emmanuelhugnot/300CC-V2/README.md

<table width="100%" border="0" cellspacing="0" cellpadding="0">
  <tr>
    <td width="50%" align="center">
      P1520646
    </td>
    <td width="50%" align="center">
      P1520563
    </td>
  </tr>
</table>

# 300CC V2 – Open-Source Paste Extruder (LDM)

The **300CC V2** is an open-source extruder designed by *Emmanuel Hugnot* to make paste 3D printing practical, reliable, and accessible. Built as the evolution of the original *300CC* project, it allows anyone to experiment with materials like **clay, earth, or bio-composites** without needing expensive hardware.

By focusing on a stripped-down design where *every single component serves a clear purpose*, the entire extruder can be assembled for **under €100**.

---

## Key Features

* **Budget-Friendly:** Full assembly costs *less than €100*.
* **Minimalist Design:** Optimized geometry for straightforward assembly, easy maintenance, and reliable extrusion.
* **Versatile Materials:** Ideal for *clays, ceramic bodies, bio-materials*, and other ductile/viscous pastes.
* **FDM to LDM Conversion:** Designed specifically to help users convert standard desktop FDM 3D printers into **Liquid Deposition Modeling (LDM)** machines.

---

## Project Origins & Acknowledgments

The **V2 design** was refined in *September 2026* during a collaborative workshop with **3rd-year design students at ESAD Orléans**. This hands-on collaboration helped test, iterate, and streamline the assembly process to ensure it remains user-friendly and functional.

---

## Getting Started

1. **Check the BOM:** for the complete list of required hardware, fasteners, and electronics.
2. **Print the Parts:** Download the `.STL` files from `3D_FILES/` and slice them using recommended settings in the documentation.
3. **Assemble & Mount:** Follow the step-by-step guide in `300CCV2_Assembly_Guide.pdf` to build the 300CC V2.

---

## Community & Support

This project is built around *sharing knowledge, troubleshooting, and improving paste printing together*.

* **Discussions:** Have questions, ideas, or prints to show off? Head over to the **GitHub Discussions** tab!
* **Contributions:** Feel free to open an issue or submit a pull request if you have improvements or modifications to share.

---
## Author & Contact

Designed and developed by **Emmanuel Hugnot**. 

*  **Website:** [emmanuelhugnot.com](https://emmanuelhugnot.com)
*  **Instagram:** [@emmanuelhugnot](https://www.instagram.com/emmanuelhugnot/)

## License

This project is published under the **Creative Commons Attribution-NonCommercial (CC BY-NC)** license.

*You are free to share, adapt, and build upon this material for non-commercial purposes, provided appropriate credit is given to Emmanuel Hugnot and the 300CC V2 project.*
