emmanuelhugnot/300CC-V2/BOM_300CC_V2.csv

300CC_Extruder V2 | CC BY NC Emmanuel HUGNOT | emmanuelhugnot.com
Quantity | Pieces | Description | Link | Prices
1 | T8 - 250mm + brass nut x2 | T8 Lead screw + brass nut | https://www.amazon.fr/filet%C3%A9es-laiton-filetage-imprimante-machine/dp/B0C5M694W3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 | 6
1 | 6mm GT2 Belt - Perim. 200mm | Transmission Belt | https://www.amazon.fr/QUARKZMAN-200mm-Courroie-Crant%C3%A9e-Largeur/dp/B0H1JWG13S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 | 9,99
1 | Thrust ball bearing | 21x12x5 | https://www.amazon.fr/Kozelo-Roulement-Billes-Pouss%C3%A9e-F12-21M/dp/B0D99DKXSC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 | 9,49
1 | Syringe 300ml | Cartridge | https://www.amazon.fr/cylindre-plastique-laboratoires-scientifiques-industrie/dp/B09CMKM2GF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 | 12,99
1 | Nema 17 + gearbox | Main motor | https://www.amazon.fr/Giilayky-D%C3%A9Rivations-Nema17-Moteur-ExtrudeuseMoteur/dp/B0CP9FNC16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 | 26
1 | 1kg PETG |  | https://www.amazon.fr/DEEPLEE-Filament-30-600mm-Pr%C3%A9cision-Imprimantes/dp/B0DS5TSR6F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 | 19
1 | M3-10mm Pack | Pack of 50 | https://www.amazon.fr/Kozelo-50Pcs-T%C3%AAte-Cylindrique-Creux/dp/B0DDJBKP17?adgrpid=56499440312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 | 8,59
1 | M4 - 35mm | Pack of 10 | https://www.amazon.fr/PRORAJE-M4x35-Filetage-Total-Hexagonale/dp/B0GFH1SPFR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 | 6
 |  |  | Total : | 98,06
