emmanuelhugnot/300CC-V2/3D_FILES/Mainboard.stl

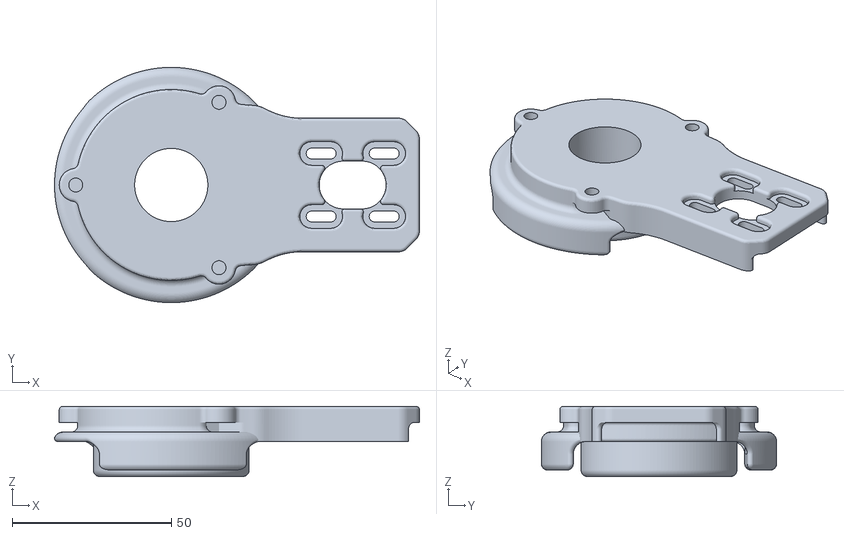
[picture p1: CAD file, 2026-10-01]
3D_FILES/Mainboard.stl
114.7 x 73.9 x 22.0
