emmanuelhugnot/300CC-V2/3D_FILES/Top_mainboard.stl

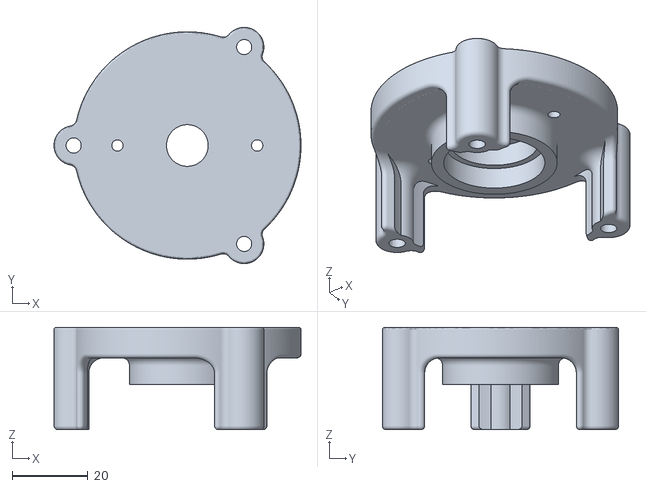
[picture p2: CAD file, 2026-10-01]
3D_FILES/Top_mainboard.stl
65.2 x 62.4 x 27.0
