emmanuelhugnot/300CC-V2/3D_FILES/mount_300CC.stl

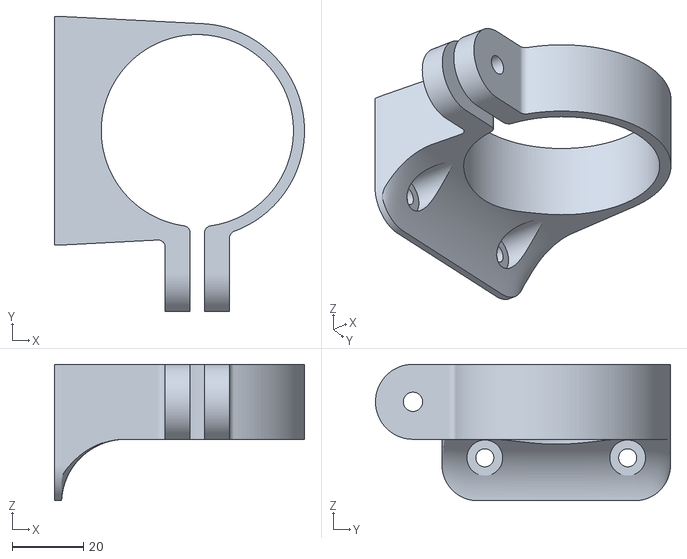
[picture p3: CAD file, 2026-10-01]
3D_FILES/mount_300CC.stl
70.0 x 82.6 x 38.2
