emmanuelhugnot/300CC-V2/3D_FILES/Support_tube.stl

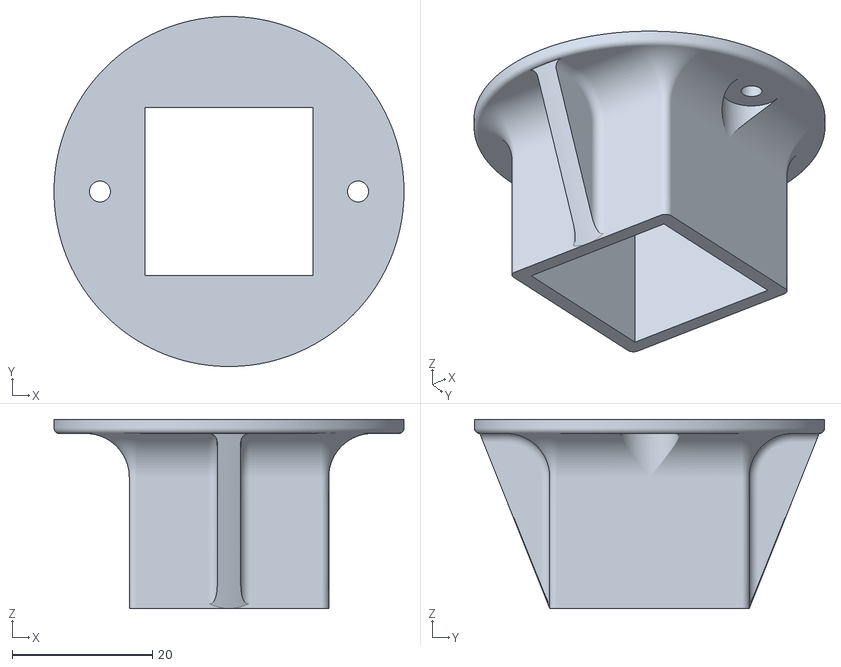
[picture p4: CAD file, 2026-10-01]
3D_FILES/Support_tube.stl
50.0 x 50.0 x 27.0
