emmanuelhugnot/300CC-V2/3D_FILES/Piston.stl

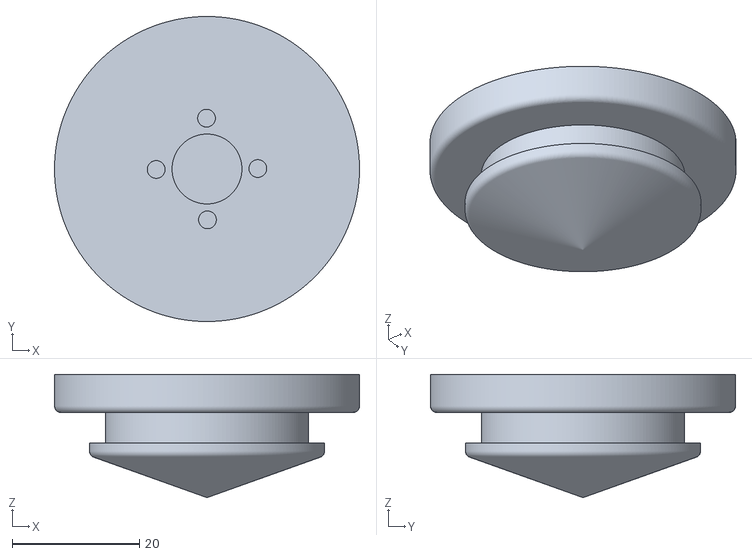
[picture p5: CAD file, 2026-10-01]
3D_FILES/Piston.stl
48.0 x 48.0 x 19.4
