emmanuelhugnot/300CC-V2/3D_FILES/Small_pulley.stl

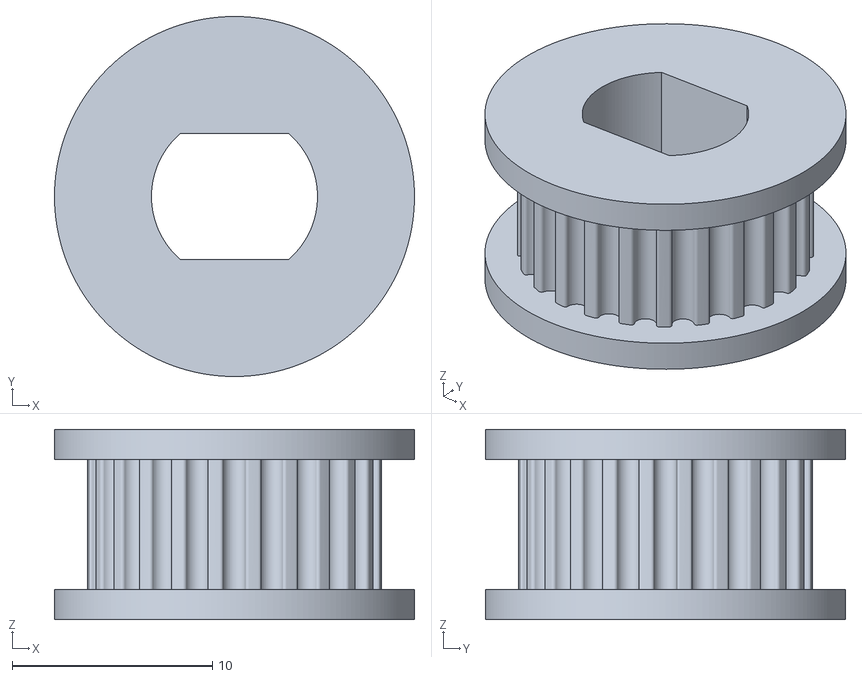
[picture p6: CAD file, 2026-10-01]
3D_FILES/Small_pulley.stl
18.0 x 18.0 x 9.50
