emmanuelhugnot/300CC-V2/3D_FILES/Block_tube.stl

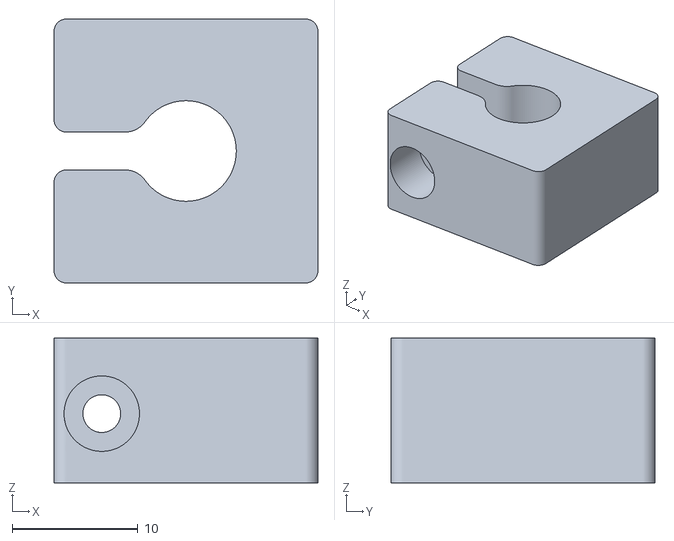
[picture p7: CAD file, 2026-10-01]
3D_FILES/Block_tube.stl
21.0 x 21.0 x 11.5
