emmanuelhugnot/300CC-V2/3D_FILES/Big_pulley.stl

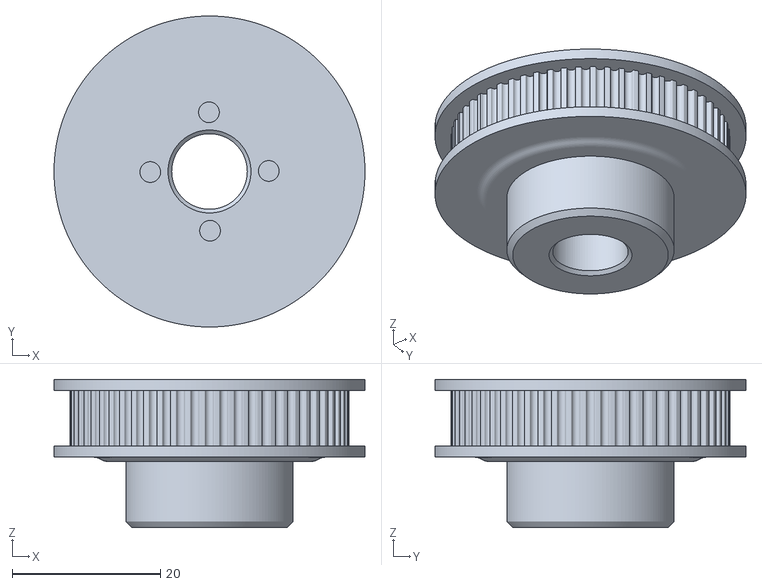
[picture p8: CAD file, 2026-10-01]
3D_FILES/Big_pulley.stl
42.0 x 42.0 x 20.0
