emmanuelhugnot/300CC-V2/300CCV2_Assembly_Guide.pdf

# 300CC Extruder V2

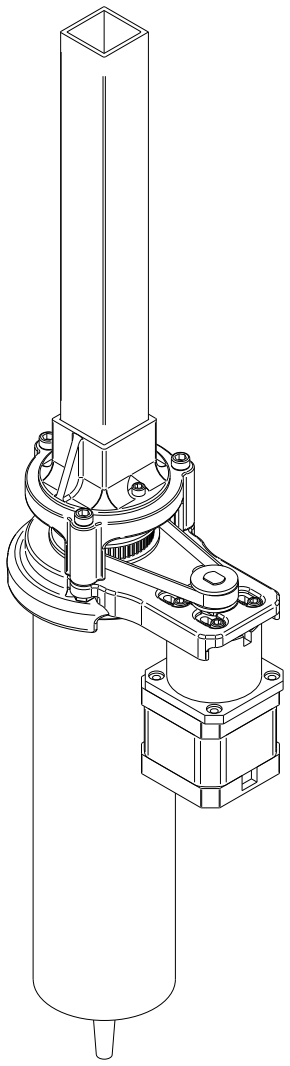
[picture p9: figure]

The 300CC V2 is the next iteration of the open-source 300CC project, designed by Emmanuel Hugnot to make paste 3D printing practical and accessible. The main goal is simple: allow anyone to experiment with materials like clay or bio-composites without needing an expensive setup. By focusing on a strippeddown design where every single part has a purpose, the entire extruder can be built for under €100.
Beyond the hardware, the project is about building a helpful community around paste printing and showing how easy it is to convert a standard FDM 3D printer into a Liquid Deposition Modeling (LDM) machine. This V2 model was developed in collaboration with third-year students at ESAD Orléans during a hands-on workshop in September 2026. Published under a Creative Commons CC BY-NC license, the design is open for makers, designers, and curious builders to use, tweak, and learn from together.
More at : emmanuelhugnot.com/300CCV2.html
CC BY NC Emmanuel Hugnot 2026

T8 Lead screw - 250mm + brass nut x2 6mm GT2 Belt - Perim. 200mm Syringe 300ml/cc
Nema 17 + gearbox
Thrust bearing 21x12x5
PETG Filament
15x M3-10mm
3x M4-35mm
Hardware : | BOM link :

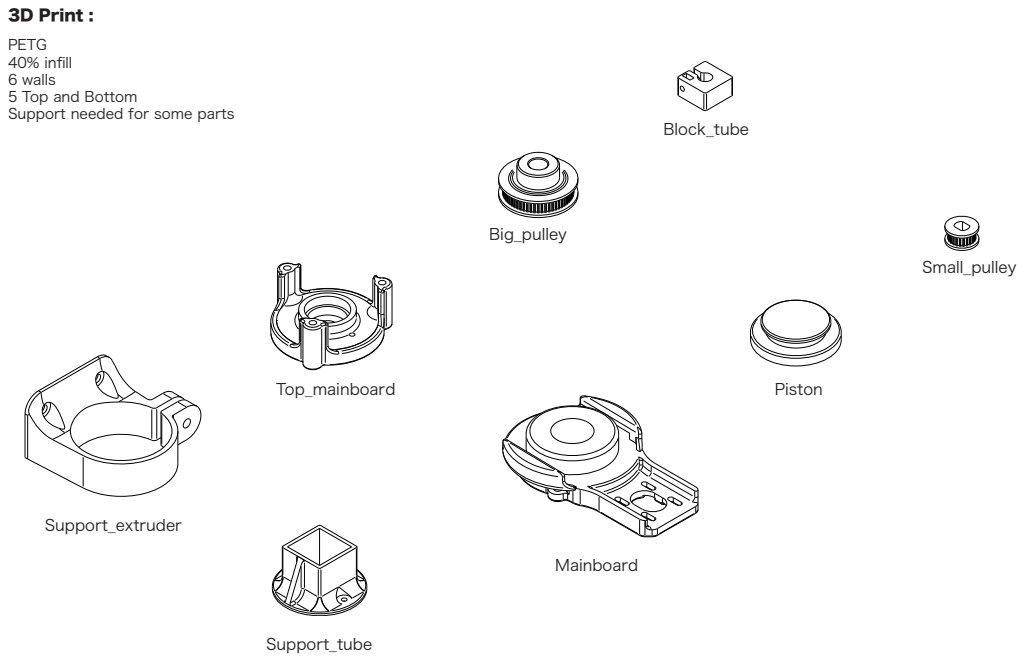
[picture p10: page 3]
Small_pulley; Top_mainboard; Piston; Mainboard; Big_pulley; Support_extruder; Block_tube; Support_tube

3D Print :
PETG
40% infill
6 walls
5 Top and Bottom
Support needed for some parts

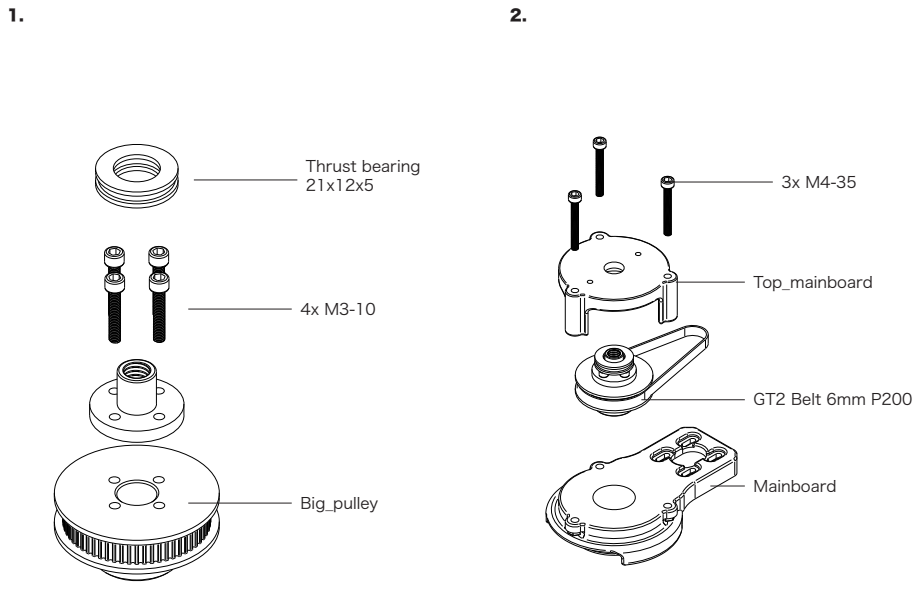
[picture p11: page 4]
Thrust bearing 21x12x5; GT2 Belt 6mm P200; Top_mainboard; Mainboard; Big_pulley

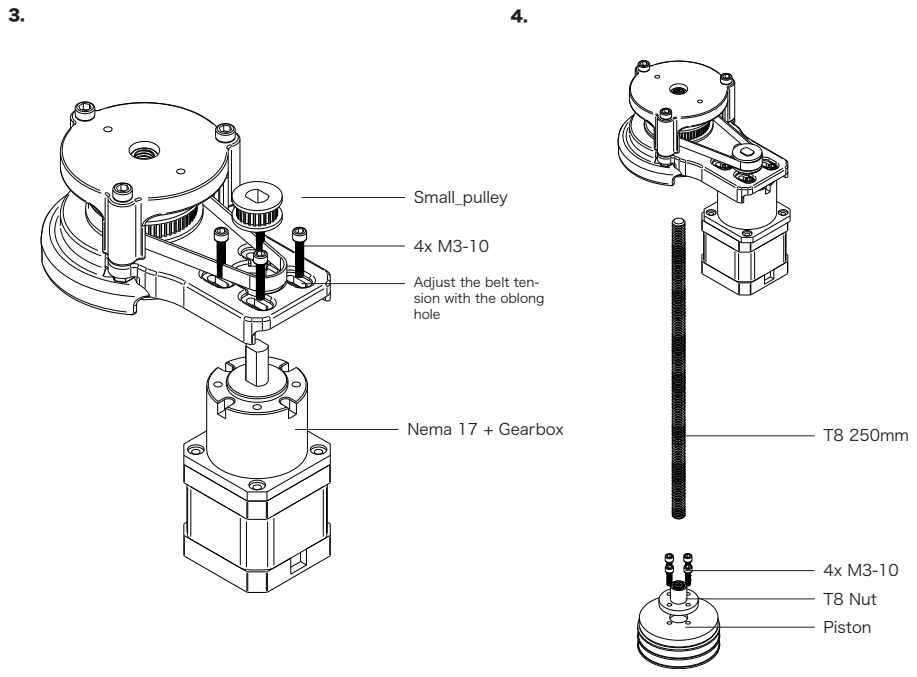
[picture p12: page 5]
Small_pulley; Nema 17 + Gearbox; T8 Nut Piston

Adjust the belt ten-
sion with the oblong
hole

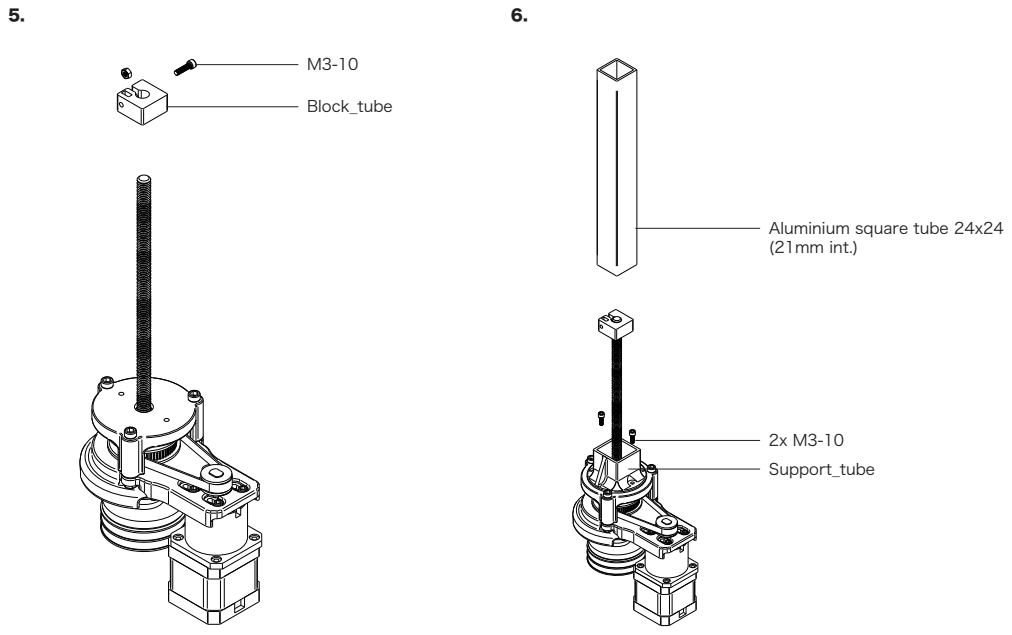
[picture p13: page 6]
Block_tube; Support_tube

Aluminium square tube 24x24
(21mm int.)

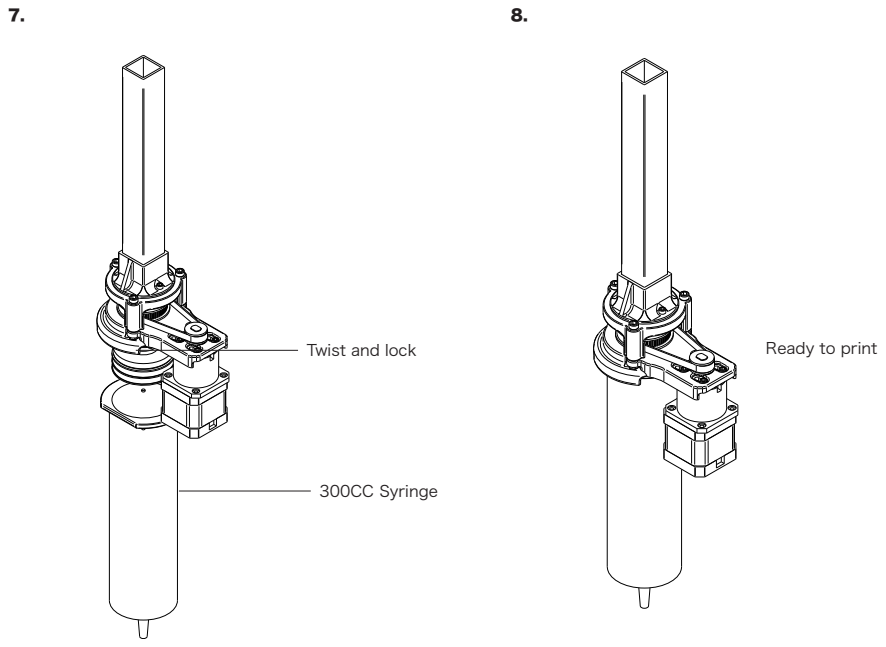
[picture p14: page 7]
300CC Syringe; Twist and lock; Ready to print
